akita11/MetalDetector/Measurement/README.md

# 電磁界強度の測定方法と測定結果

## 関連する法令と基準

LDC1612を基板パターンコイルで使う金属検出センサは、10kHz以上の高周波電流を利用するため、電波法第100条第1項第2号の「高周波利用設備（通信設備以外）」に該当し得る。ただし、同号により許可が必要となるのは総務省令で定める設備に限られ、電波法施行規則第45条では、医療用設備・工業用加熱設備・各種設備のうち高周波出力が50Wを超えるものとされている。本機の高周波出力はmWオーダーであり、設置許可は不要である。

一方、許可を要しない設備であっても、副次的に発する電波または高周波電流が無線設備の機能に継続的かつ重大な障害を与えるときは、障害除去のための措置を命じられることがある（電波法第101条により第82条第1項を準用）。

本機のコイル駆動周波数は約2MHz（LDC1612の対応範囲は1kHz〜10MHz）である。この周波数範囲で障害を与える可能性がある主な無線システムはAMラジオ放送（526.5〜1,606.5kHz）である。本機に直接適用される数値基準はないため、参考として、型式確認を受ける電磁誘導加熱式調理器の基準（電波法施行規則第46条の7：発振器から30mの距離で、526.5〜1,606.5kHzにおいて30μV/m以下）を設計目標とした。近傍界では電界は1/rより速く減衰するため、1/rで換算した「3mの距離で300μV/m（約50dBμV/m）以下」を満たせば、30mでの基準も安全側で満たすと判断できる。

## 測定方法・機材

- 測定日：2026/11/9
- 測定場所：石川県工業試験場（石川県金沢市鞍月2-1）
- 測定機材
 - エミッション測定装置
  - スペクトラム・アナライザ: Rohde&Schwarz ESU26
  - ループアンテナ: Rohde&Schwarz HFH2-Z2
  - 解析ソフトウエア：東陽テクニカ・EP5/ME
 - 電波無響室（トーキン、主な仕様は以下の通り）
  - 周波数範囲：30MHz〜18GHz
  - シールド性能：100dB以上
  - 面積：40m2（W8m x D5m x H6.3m）
  - ターンテーブル：直径2m
- 測定環境：MeasurementSetup.png の通り

## 測定結果

ループ面の向きが0度と90度の両者に対して測定した磁界強度から、電界強度に換算（+51.5dB）したEMI強度の結果は MetalDetector_EMI.pdf（1ページ目が0度、2ページ目が90度） の通り。
すべての帯域で50dBuV/m以下であることが確認できる。
