akita11/MetalDetector/MetalDetectorUnit_sch.pdf

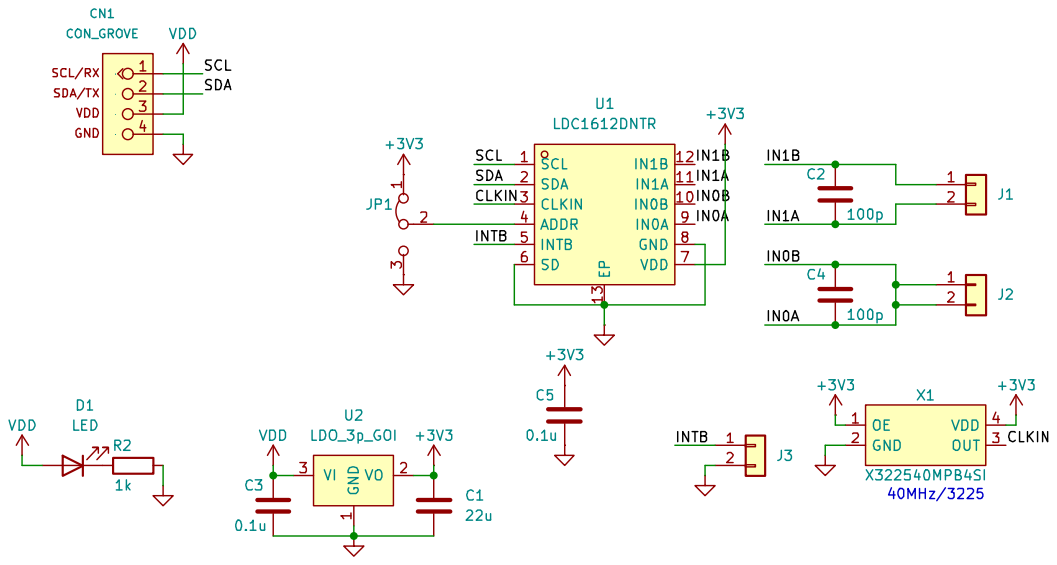
[picture p1: page 1]
