akita11/MetalDetector/MetalDetectorUnit.kicad_pcb

## KiCad design MetalDetectorUnit.kicad_pcb (2026-11-11)

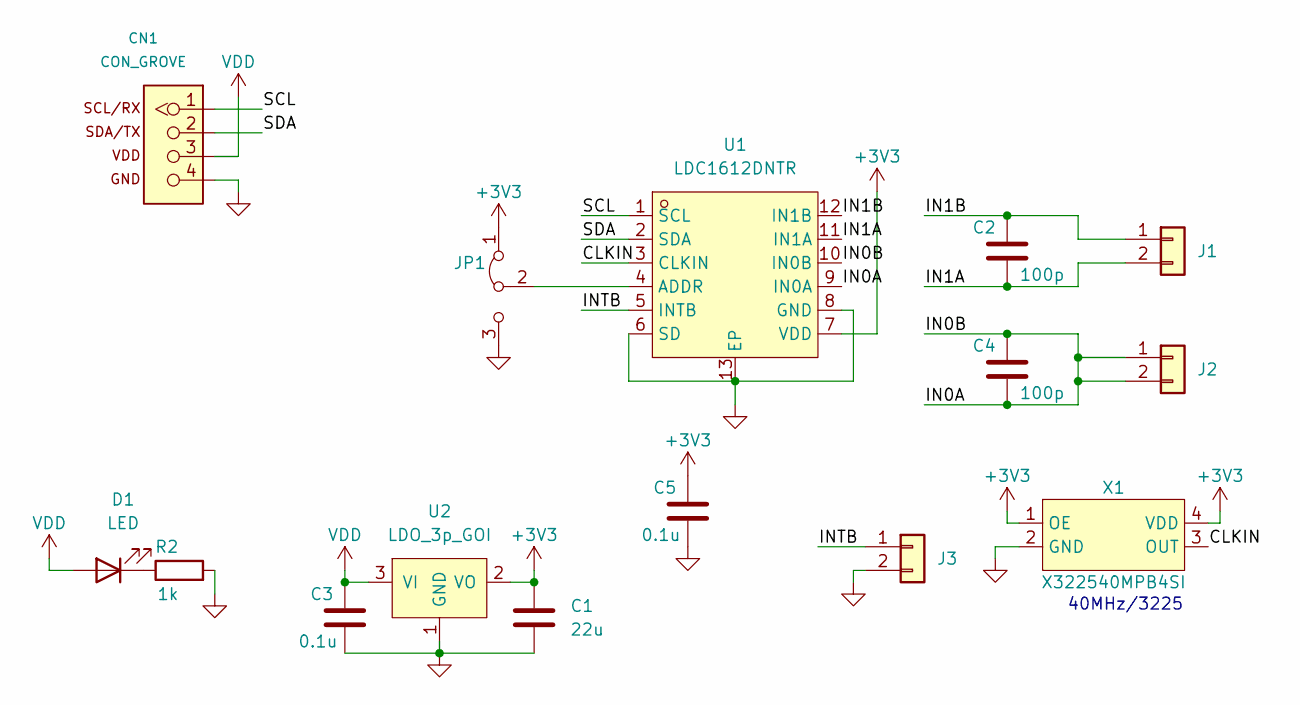
[picture p2: schematic MetalDetectorUnit.kicad_sch]

Parts:
C1: 22u; C_0603_1608Metric; LCSC C19702
C2, C4: 100p; C_0603_1608Metric; LCSC C14858
C3, C5: 0.1u; C_0603_1608Metric; LCSC C14663
CN1: CON_GROVE; CON_GROVE_H
D1: LED; D_0603_1608Metric
J1, J2, J3: Conn_01x02; PinHeader_1x02_P2.54mm_Vertical
JP1: Jumper_3_Bridged12; SolderJumper-3_P1.3mm_Bridged12_Pad1.0x1.5mm
R2: 1k; R_0603_1608Metric
U1: LDC1612DNTR; WSON-12_L4.0-W4.0-P0.50-BL-EP; MPN LDC1612DNTR; LCSC Part C1847959
U2: LDO_3p_GOI; SOT-23; LCSC C41376473
X1: X322540MPB4SI; OSC-SMD_4P-L3.2-W2.5-BL; LCSC Part C9010

Connections:
+3V3: C1.1, C5.1, JP1.1 (A), U1.7 (VDD), U2.2 (VO), X1.1 (OE), X1.4 (VDD)
/CLKIN: U1.3 (CLKIN), X1.3 (OUT)
/IN0A: C4.1, C4.2, J2.1, J2.2, U1.9 (IN0A), U1.10 (IN0B)
/IN1A: C2.2, J1.2, U1.11 (IN1A)
/IN1B: C2.1, J1.1, U1.12 (IN1B)
/INTB: J3.1, U1.5 (INTB)
/SCL: CN1.1, U1.1 (SCL)
/SDA: CN1.2, U1.2 (SDA)
GND: C1.2, C3.2, C5.2, CN1.4, J3.2, JP1.3 (B), R2.2, U1.6 (SD), U1.8 (GND), U1.13 (EP), U2.1 (GND), X1.2 (GND)
unnamed: D1.1 (K), R2.1
unnamed: JP1.2 (C), U1.4 (ADDR)
VDD: C3.1, CN1.3, D1.2 (A), U2.3 (VI)

Notes on the sheet:
40MHz/3225

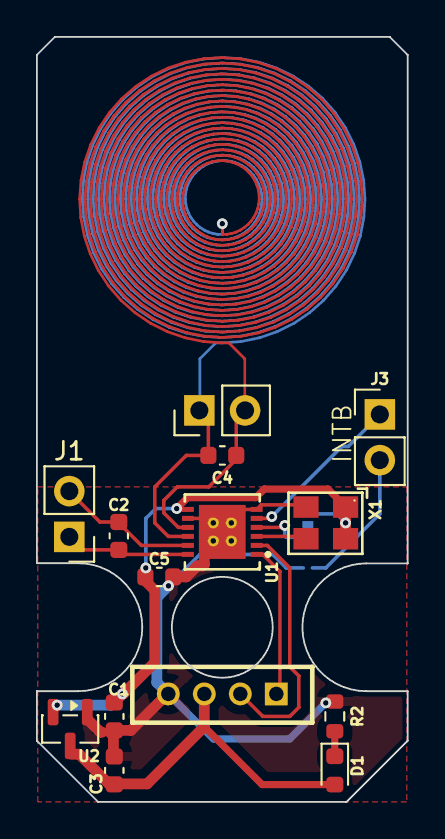
[picture p3: board MetalDetectorUnit.kicad_pcb from above]

Board: 2 copper layers, 20.6 x 42.5 mm, 15 parts (1 on the bottom side), 12 nets.
