akita11/MetalDetector/Measurement/MetalDetector_EMI.pdf

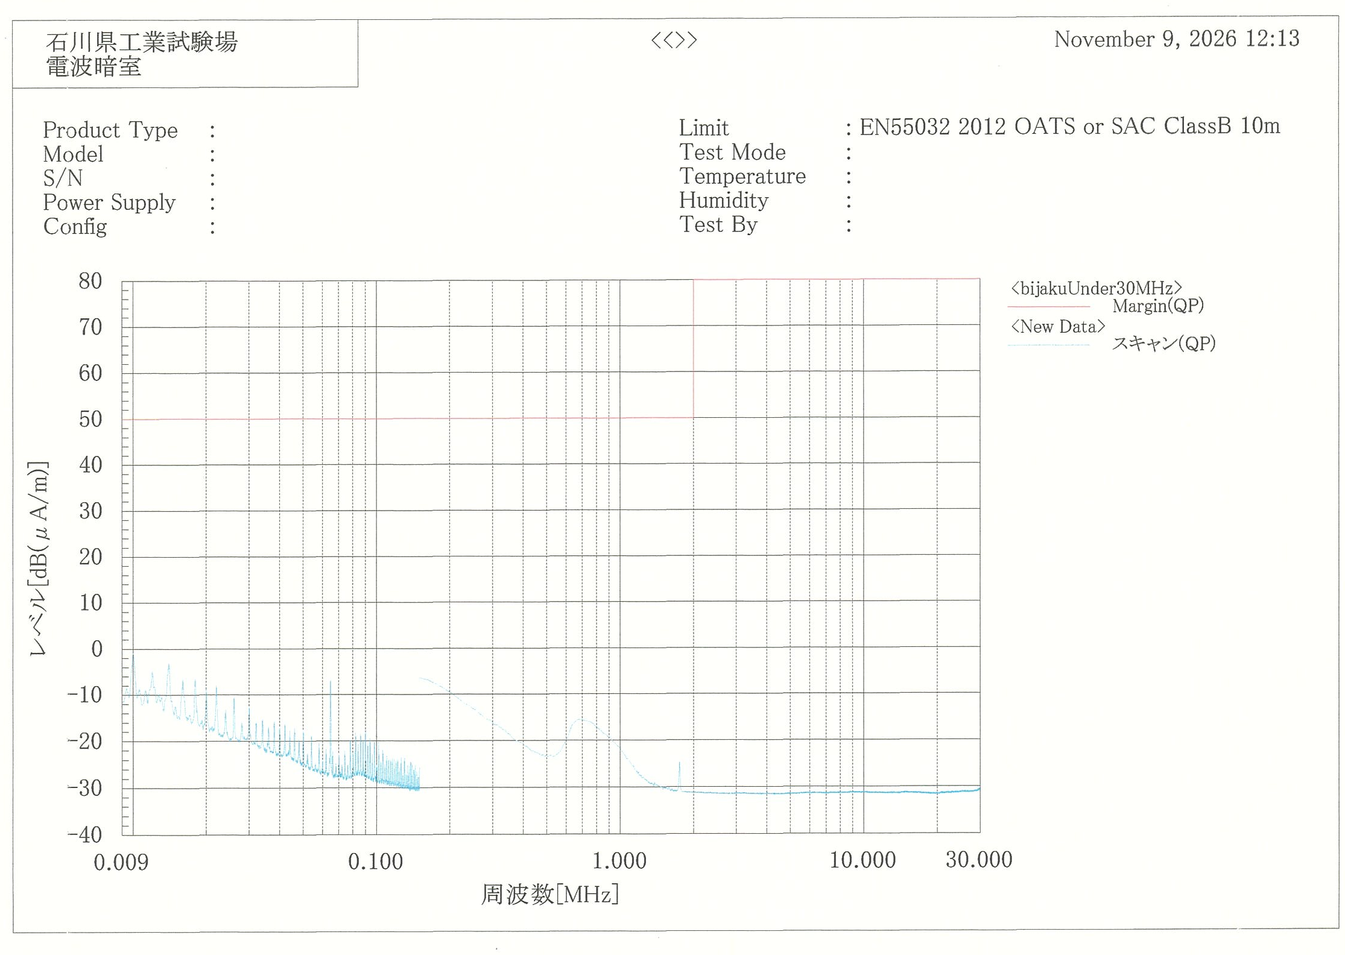
[picture p5: page 1]
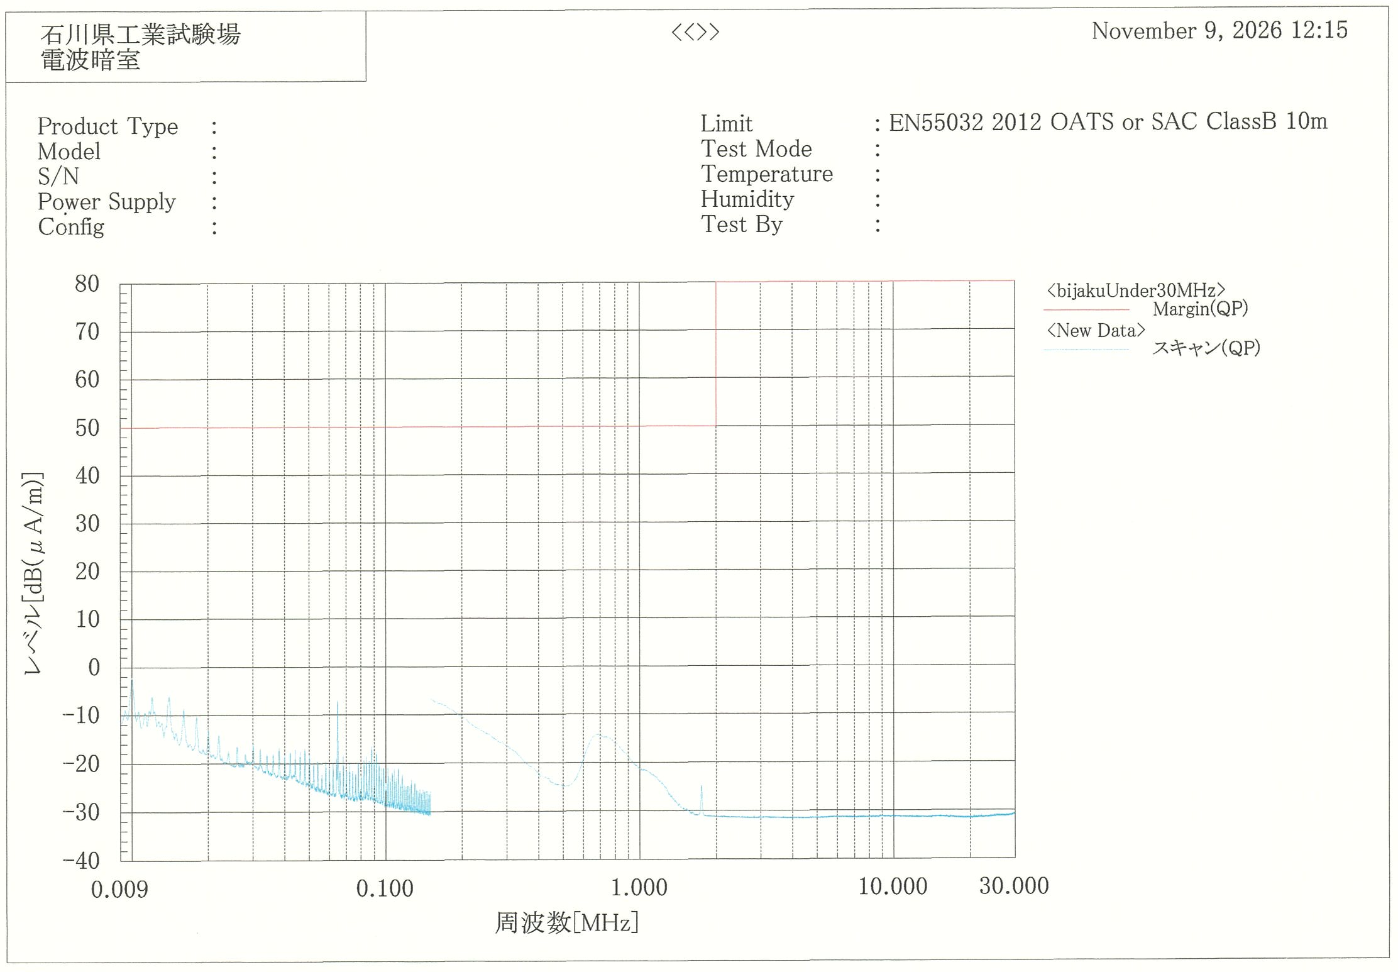
[picture p6: page 2]
