akita11/MetalDetector/Measurement/MeasurementSetup.png

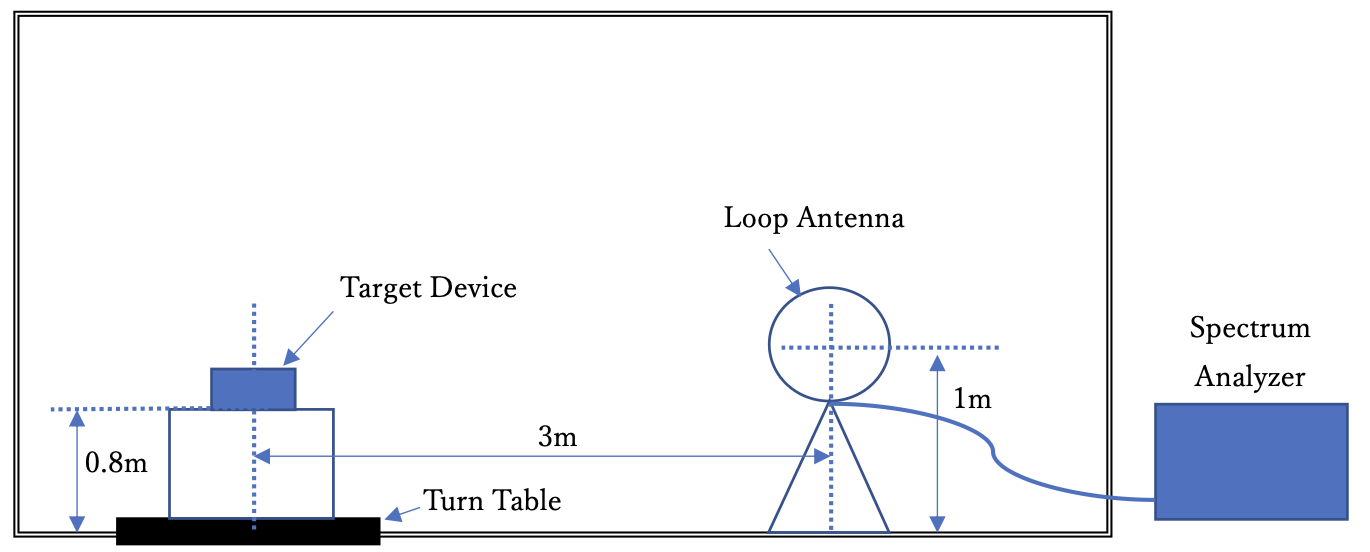
Measurement/MeasurementSetup.png
